wero1414/hack-it-back/Hw/sensor-co2/sensor-co2.step

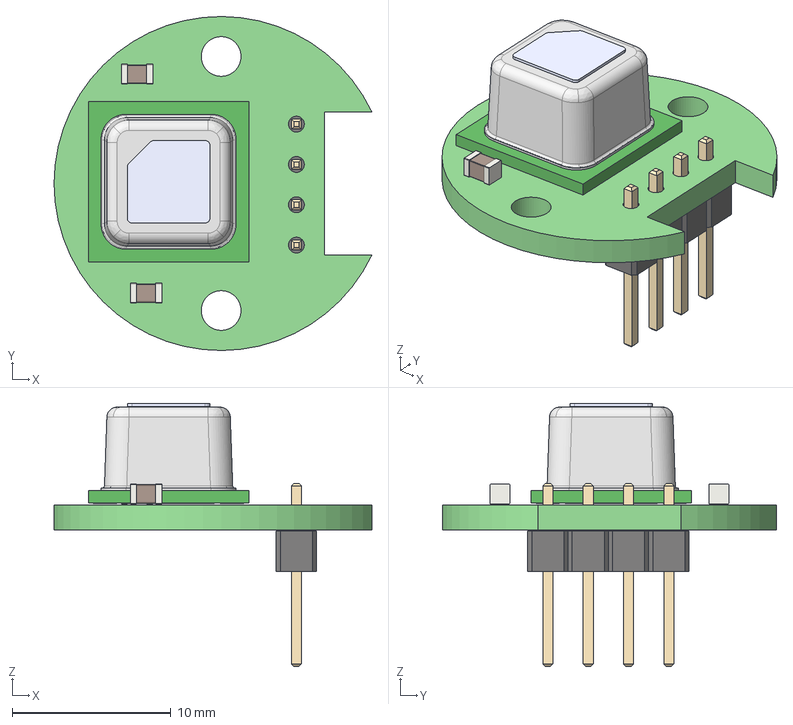
[picture p1: CAD file, 2022-03-23]
Hw/sensor-co2/sensor-co2.step
20.0 x 21.0 x 16.6 mm
sensor-co2 PCB
