wero1414/hack-it-back/Hw/sensor-exp/sensor-exp.step

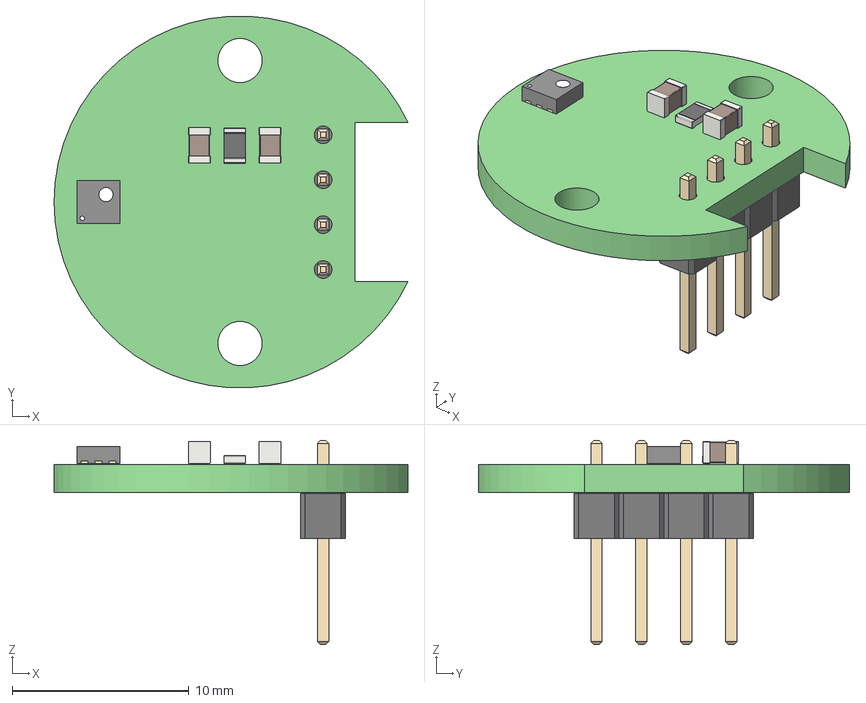
[picture p2: CAD file, 2022-03-23]
Hw/sensor-exp/sensor-exp.step
20.0 x 21.0 x 11.5 mm
_autosave-sensor-exp PCB
