wero1414/hack-it-back/Hw/main-board/Board2Pdf/main-board-Assembly.pdf

A

A

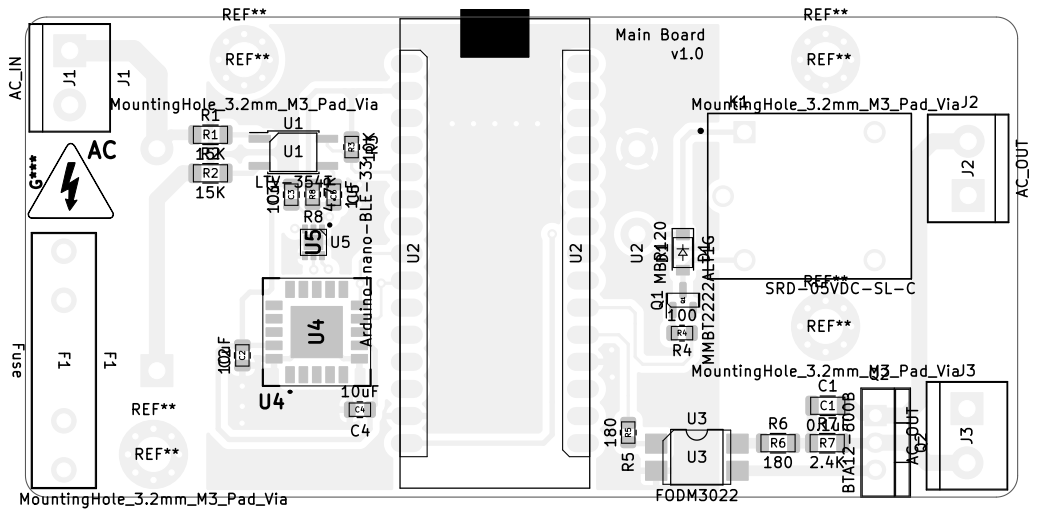
[picture p3: page 1]

PS1 1 | 2 | 3 | 4 | 5 | 6

A

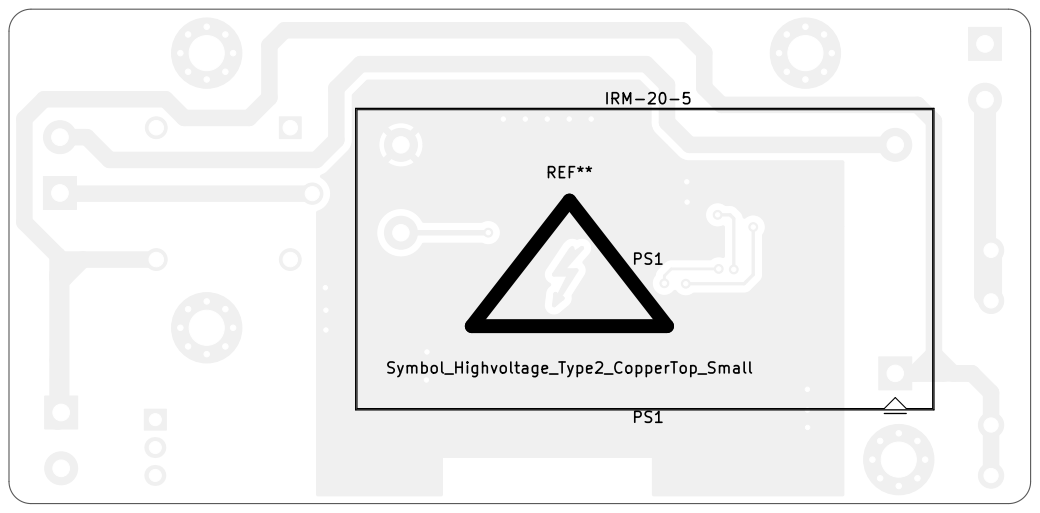
[picture p4: page 2]
D Date: KiCad E.D.A. kicad (6.0.0) Size: A4; Rev:; IRM-20-5 PS1 REF** Symbol_Highvoltage_Type2_CopperTop_Small

Sheet: Assembly
File: main-board.kicad_pcb
Id: 1/1 Title:
