wero1414/hack-it-back/Hw/main-board/main-board.kicad_pcb

## KiCad design Hw/main-board/main-board.kicad_pcb (2022-04-23)

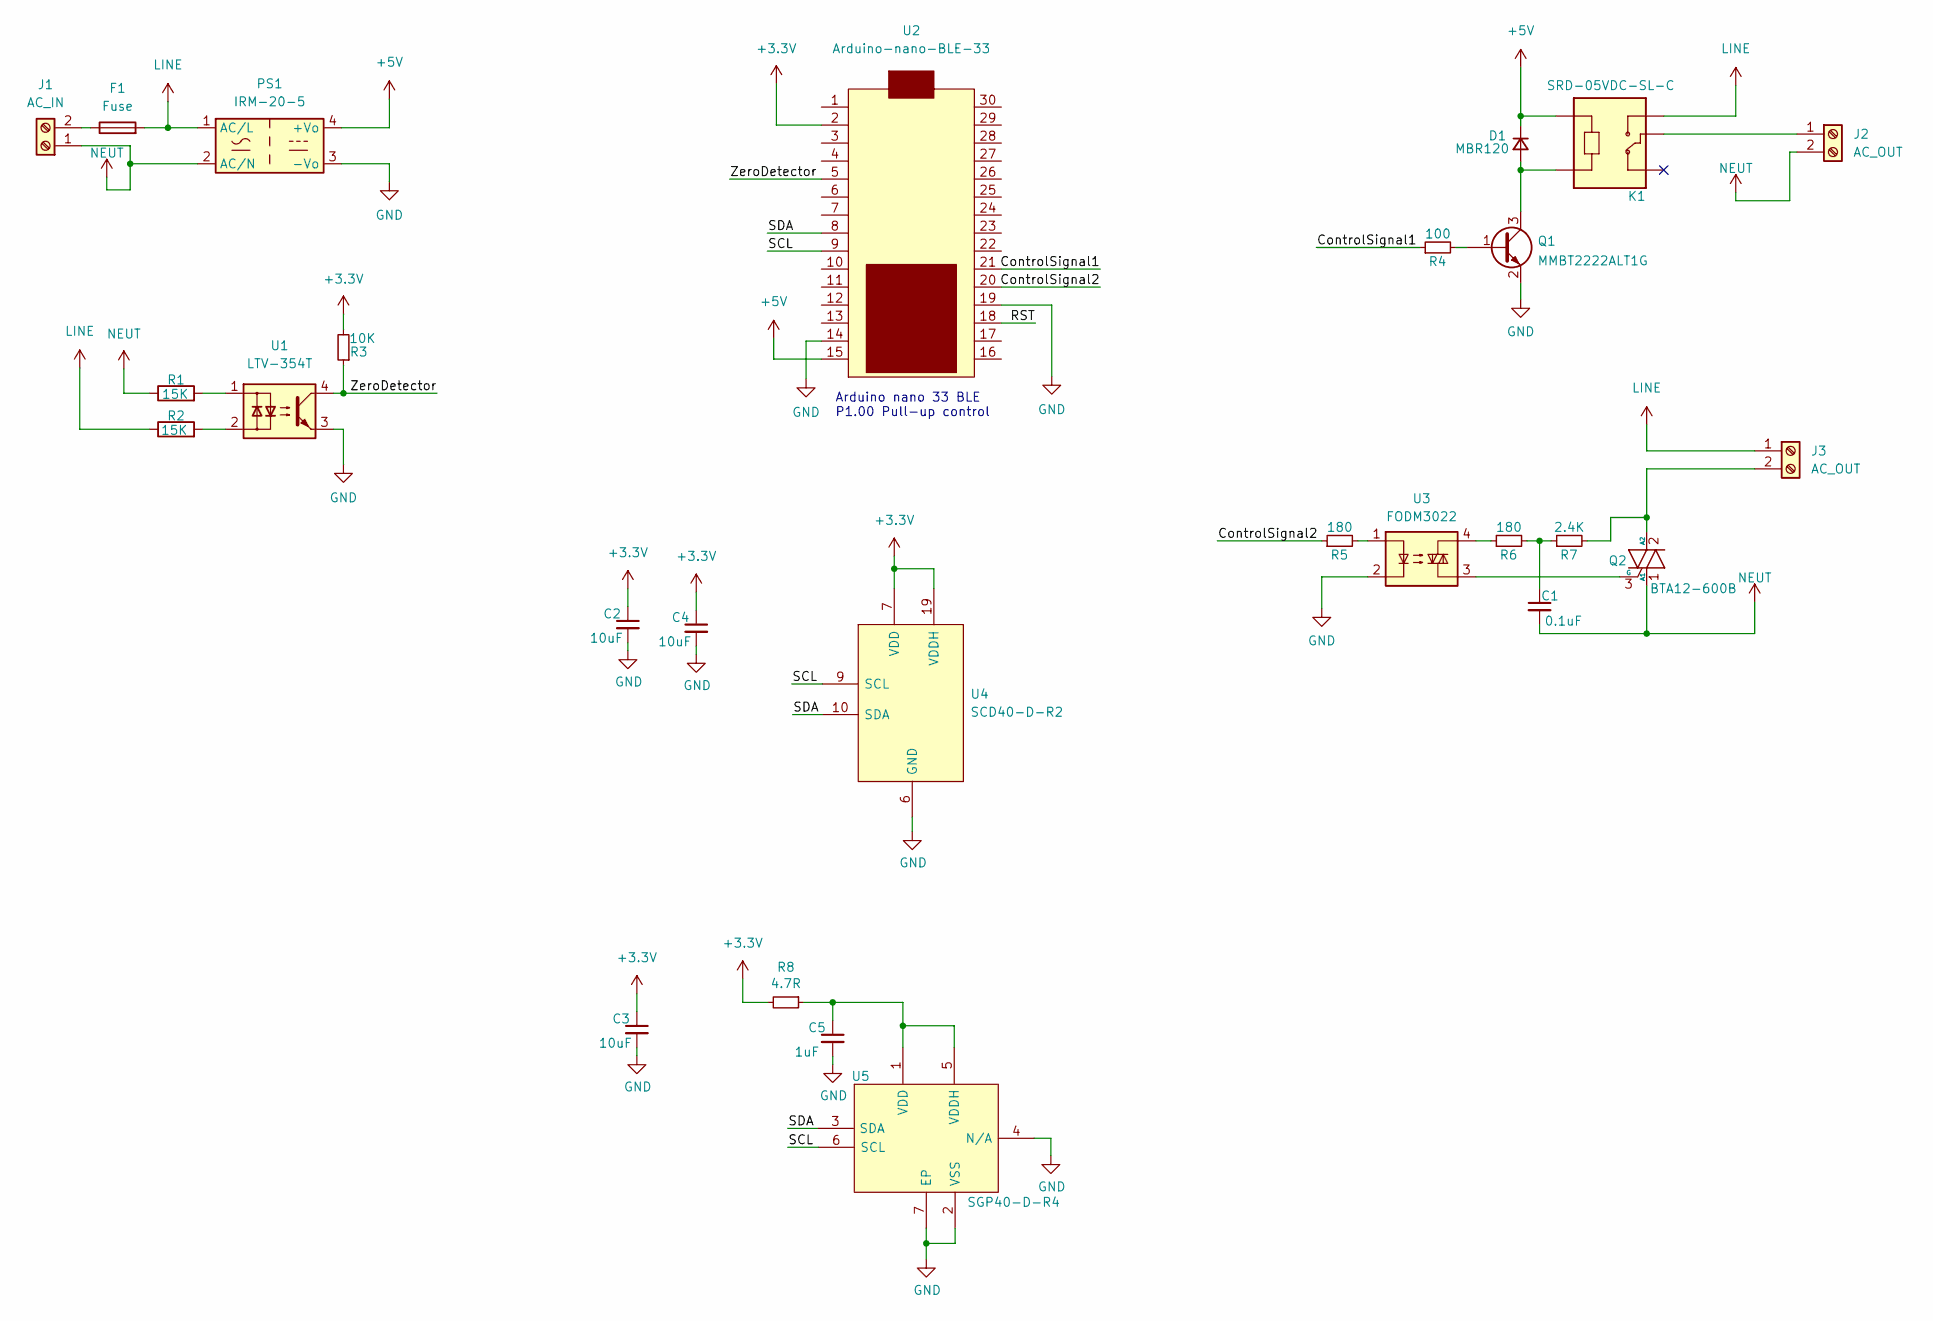
[picture p5: schematic main-board.kicad_sch]

Parts:
C1: 0.1uF; C_1206_3216Metric
C2, C3, C4: 10uF; C_0805_2012Metric
C5: 1uF; C_0805_2012Metric
D1: MBR120; D_SOD-123
F1: Fuse; Fuseholder_Littelfuse_100_series_5x20mm
J1: AC_IN; TerminalBlock_bornier-2_P5.08mm
J2, J3: AC_OUT; TerminalBlock_bornier-2_P5.08mm
K1: SRD-05VDC-SL-C; RELAY_SRD-05VDC-SL-C
PS1: IRM-20-5; Converter_ACDC_MeanWell_IRM-20-xx_THT
Q1: MMBT2222ALT1G; SOT-23
Q2: BTA12-600B; TO-220-3_Vertical
R1, R2: 15K; R_1206_3216Metric
R3: 10K; R_0805_2012Metric
R4: 100; R_0805_2012Metric
R5: 180; R_0805_2012Metric
R6: 180; R_1206_3216Metric
R7: 2.4K; R_1206_3216Metric
R8: 4.7R; R_0805_2012Metric
U1: LTV-354T; SO-4_4.4x3.6mm_P2.54mm
U2: Arduino-nano-BLE-33; NANO_33_Footprint_SMD_Castell
U3: FODM3022; SMDIP-4_W7.62mm
U4: SCD40-D-R2; SCD40DR2
U5: SGP40-D-R4; SON80P244X244X95-7N

Connections:
+3V3: C2.1, C3.1, C4.1, R3.2, R8.2, U2.2, U4.7 (VDD), U4.19 (VDDH)
+5V: D1.1 (K), K1.A1, PS1.4 (+Vo), U2.15
/ControlSignal1: R4.1, U2.21
/ControlSignal2: R5.1, U2.20
/RST: U2.18
/SCL: U2.9, U4.9 (SCL), U5.6 (SCL)
/SDA: U2.8, U4.10 (SDA), U5.3 (SDA)
/ZeroDetector: R3.1, U1.4, U2.5
GND: C2.2, C3.2, C4.2, C5.2, PS1.3 (-Vo), Q1.2 (E), U1.3, U2.14, U2.19, U3.2, U4.6 (GND), U4.20 (GND_2), U4.21 (GND_3), U5.2 (VSS), U5.4 (N/A), U5.7 (EP)
LINE: F1.2, J3.1, K1.NO, PS1.1 (AC/L), R2.1
NEUT: C1.2, J1.1, J2.2, PS1.2 (AC/N), Q2.1 (A1), R1.1
unnamed: C1.1, R6.2, R7.1
unnamed: C5.1, R8.1, U5.1 (VDD), U5.5 (VDDH)
unnamed: D1.2 (A), K1.A2, Q1.3 (C)
unnamed: F1.1, J1.2
unnamed: J2.1, K1.COM
unnamed: J3.2, Q2.2 (A2), R7.2
unnamed: Q1.1 (B), R4.2
unnamed: Q2.3 (G), U3.3
unnamed: R1.2, U1.1
unnamed: R2.2, U1.2
unnamed: R5.2, U3.1
unnamed: R6.1, U3.4

Notes on the sheet:
Arduino nano 33 BLE P1.00 Pull-up control

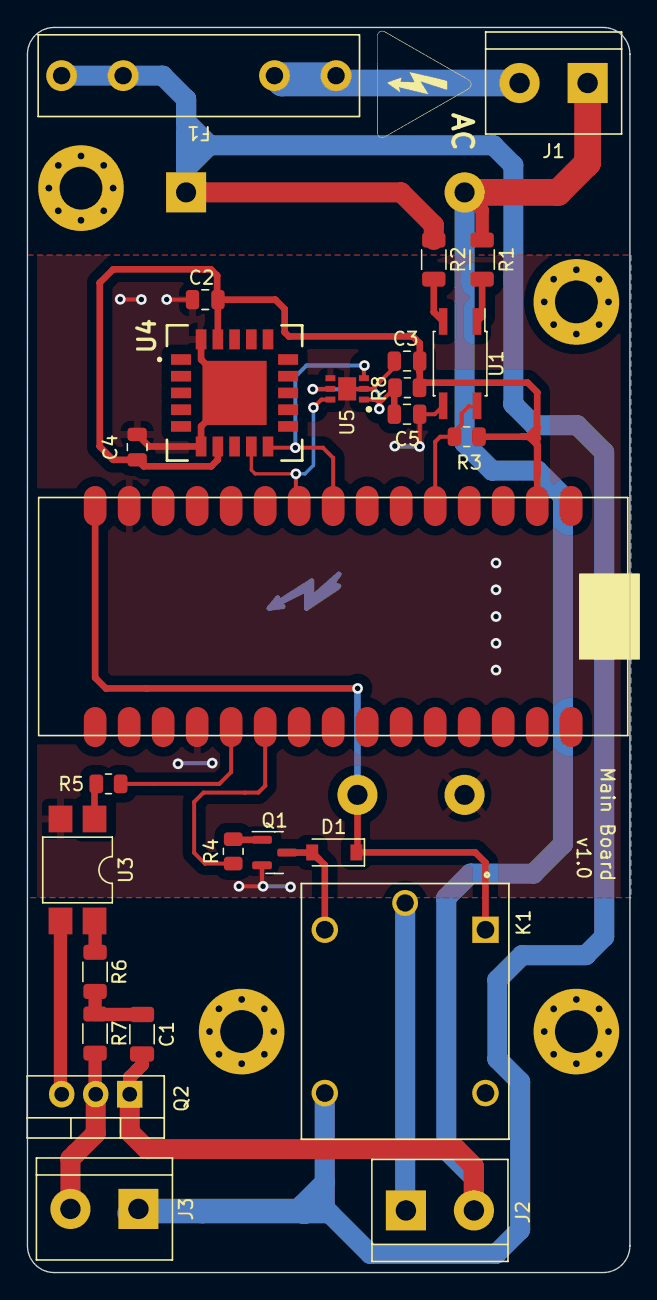
[picture p6: board main-board.kicad_pcb from above]

Board: 2 copper layers, 45.0 x 93.0 mm, 27 parts (1 on the bottom side), 22 nets.
