wero1414/hack-it-back/Hw/sensor-co2/sensor-co2.kicad_pcb

## KiCad design Hw/sensor-co2/sensor-co2.kicad_pcb (2022-03-23)

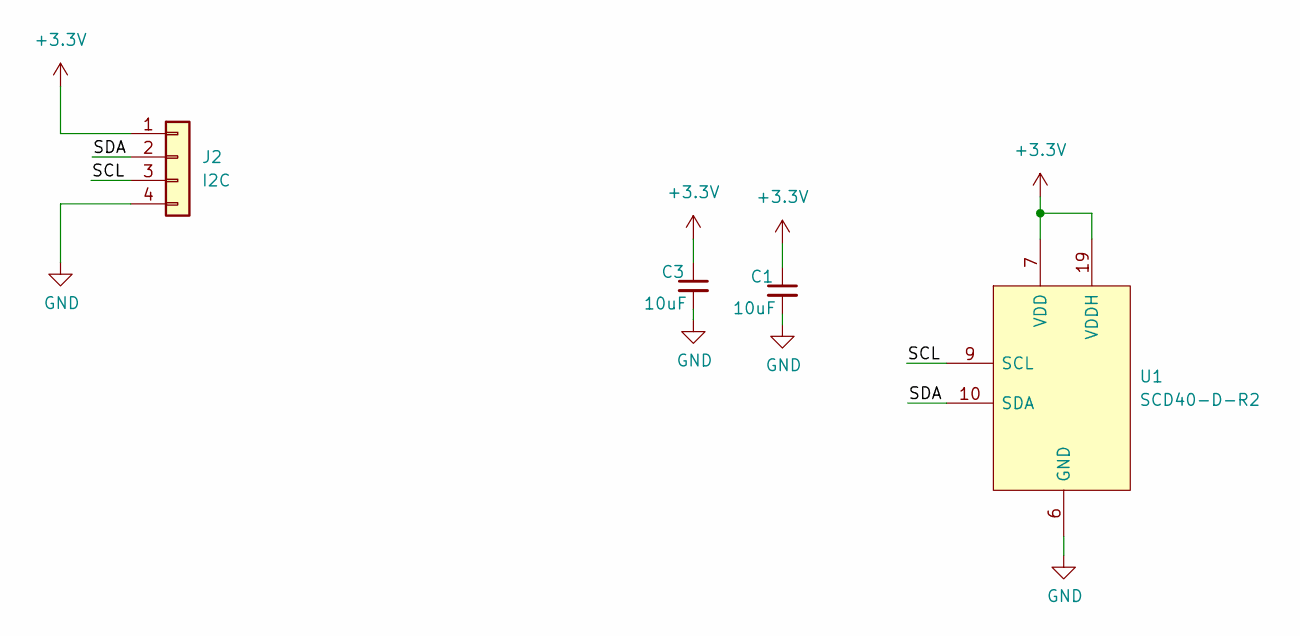
[picture p7: schematic sensor-co2.kicad_sch]

Parts:
C1, C3: 10uF; C_0805_2012Metric
J2: I2C; PinHeader_1x04_P2.54mm_Vertical
U1: SCD40-D-R2; SCD40DR2

Connections:
+3V3: C1.1, C3.1, J2.1, U1.7 (VDD), U1.19 (VDDH)
/SCL: J2.3, U1.9 (SCL)
/SDA: J2.2, U1.10 (SDA)
GND: C1.2, C3.2, J2.4, U1.6 (GND), U1.20 (GND_2), U1.21 (GND_3)

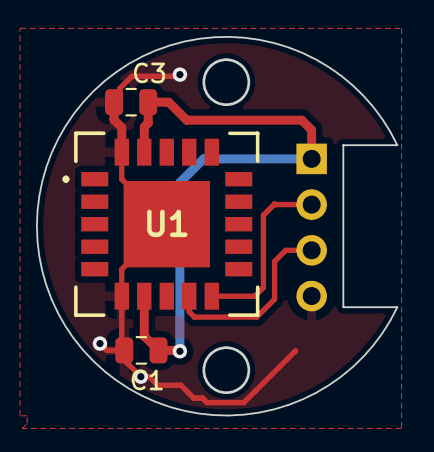
[picture p8: board sensor-co2.kicad_pcb from above]

Board: 2 copper layers, 20.0 x 21.0 mm, 4 parts (1 on the bottom side), 4 nets.
