wero1414/hack-it-back/Hw/sensor-exp/sensor-exp.kicad_pcb

## KiCad design Hw/sensor-exp/sensor-exp.kicad_pcb (2022-03-23)

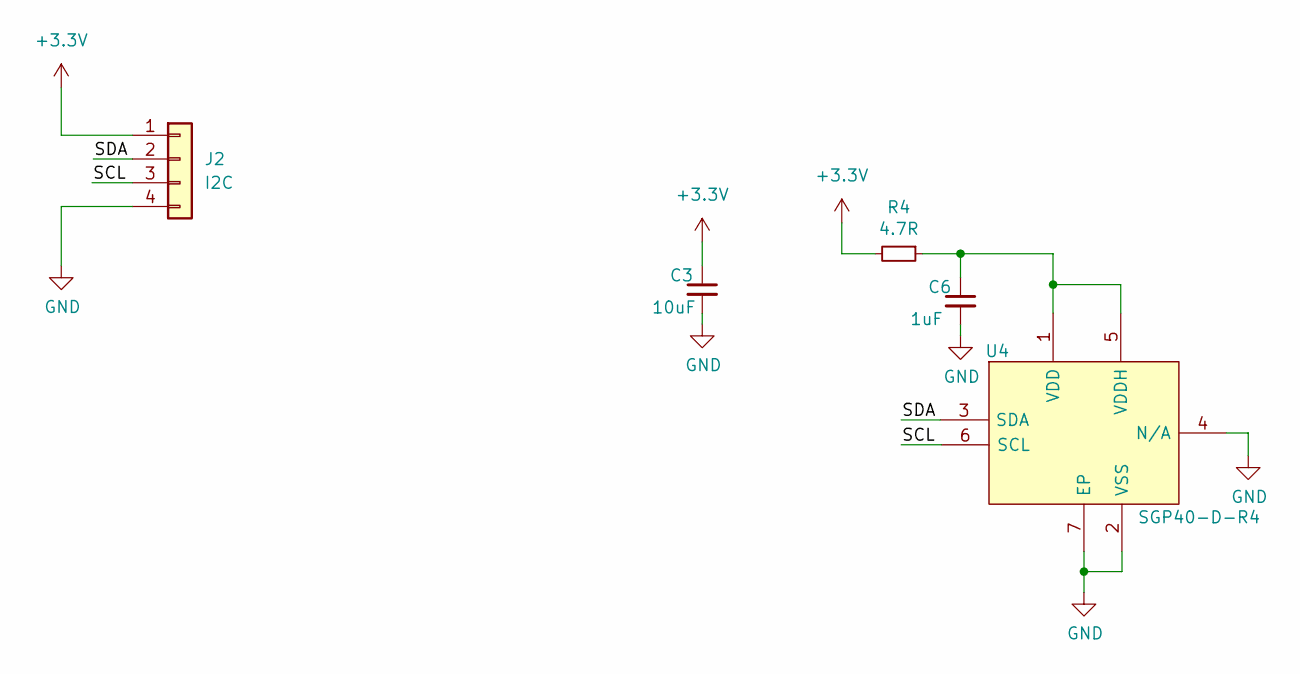
[picture p9: schematic sensor-exp.kicad_sch]

Parts:
C3: 10uF; C_0805_2012Metric
C6: 1uF; C_0805_2012Metric
J2: I2C; PinHeader_1x04_P2.54mm_Vertical
R4: 4.7R; R_0805_2012Metric
U4: SGP40-D-R4; SON80P244X244X95-7N

Connections:
+3V3: C3.1, J2.1, R4.2
/SCL: J2.3, U4.6 (SCL)
/SDA: J2.2, U4.3 (SDA)
GND: C3.2, C6.2, J2.4, U4.2 (VSS), U4.4 (N/A), U4.7 (EP)
unnamed: C6.1, R4.1, U4.1 (VDD), U4.5 (VDDH)

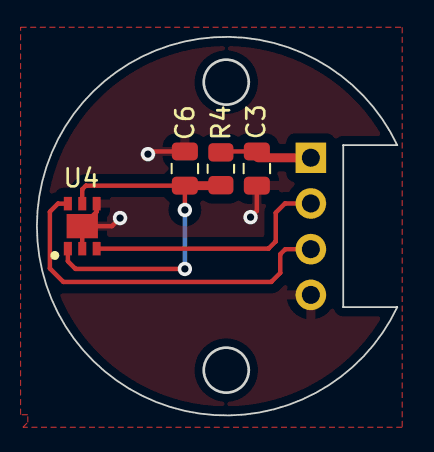
[picture p10: board sensor-exp.kicad_pcb from above]

Board: 2 copper layers, 20.0 x 21.0 mm, 5 parts (1 on the bottom side), 5 nets.
