wero1414/hack-it-back/Hw/sensor-board/sensor-board.kicad_pcb

## KiCad design Hw/sensor-board/sensor-board.kicad_pcb (2022-03-23)

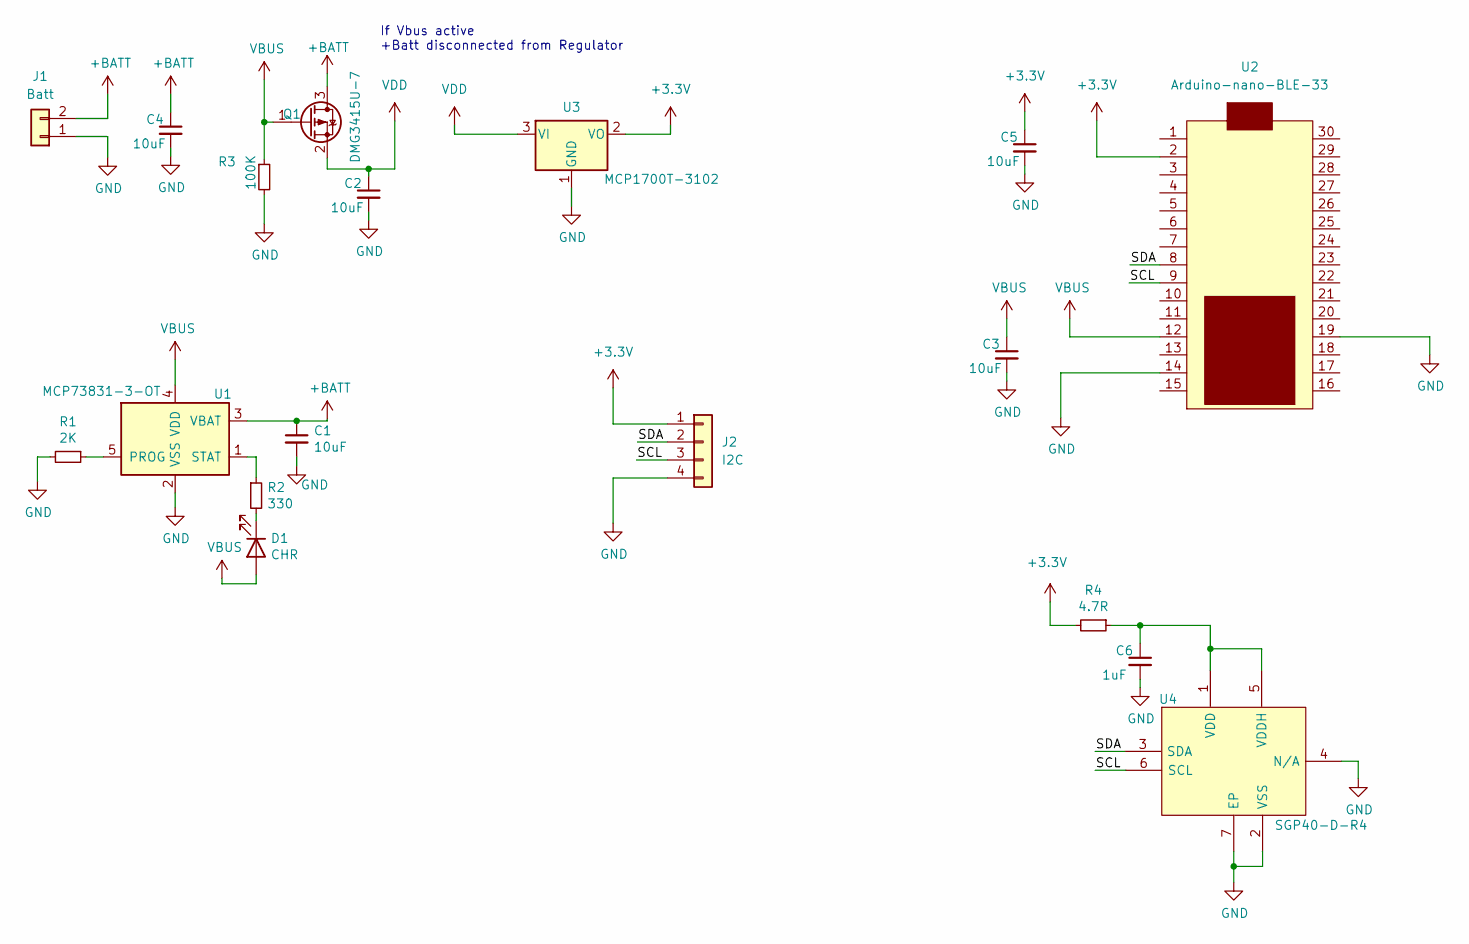
[picture p11: schematic sensor-board.kicad_sch]

Parts:
C1, C2, C3, C4, C5: 10uF; C_0805_2012Metric
C6: 1uF; C_0805_2012Metric
D1: CHR; LED_0805_2012Metric_Pad1.15x1.40mm_HandSolder
J1: Batt; PinHeader_1x02_P2.54mm_Vertical
J2: I2C; PinHeader_1x04_P2.54mm_Vertical
Q1: DMG3415U-7; SOT-23
R1: 2K; R_0805_2012Metric
R2: 330; R_0805_2012Metric
R3: 100K; R_0805_2012Metric
R4: 4.7R; R_0805_2012Metric
U1: MCP73831-3-OT; SOT-23-5
U2: Arduino-nano-BLE-33; NANO_33_Footprint_SMD_Castell
U3: MCP1700T-3102; SOT-23
U4: SGP40-D-R4; SON80P244X244X95-7N

Connections:
+3V3: C5.1, J2.1, R4.2, U2.2, U3.2 (VO)
+BATT: C1.1, C4.1, J1.2, Q1.3 (D), U1.3 (VBAT)
/SCL: J2.3, U2.9, U4.6 (SCL)
/SDA: J2.2, U2.8, U4.3 (SDA)
GND: C1.2, C2.2, C3.2, C4.2, C5.2, C6.2, J1.1, J2.4, R1.2, R3.2, U1.2 (VSS), U2.14, U2.19, U3.1 (GND), U4.2 (VSS), U4.4 (N/A), U4.7 (EP)
unnamed: C6.1, R4.1, U4.1 (VDD), U4.5 (VDDH)
unnamed: D1.1 (K), R2.2
unnamed: R1.1, U1.5 (PROG)
unnamed: R2.1, U1.1 (STAT)
VBUS: C3.1, D1.2 (A), Q1.1 (G), R3.1, U1.4 (VDD), U2.12
VDD: C2.1, Q1.2 (S), U3.3 (VI)

Notes on the sheet:
If Vbus active +Batt disconnected from Regulator

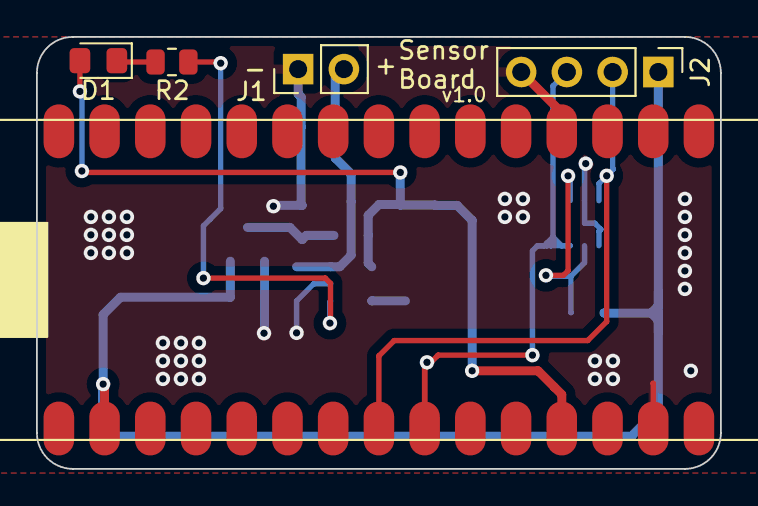
[picture p12: board sensor-board.kicad_pcb from above]

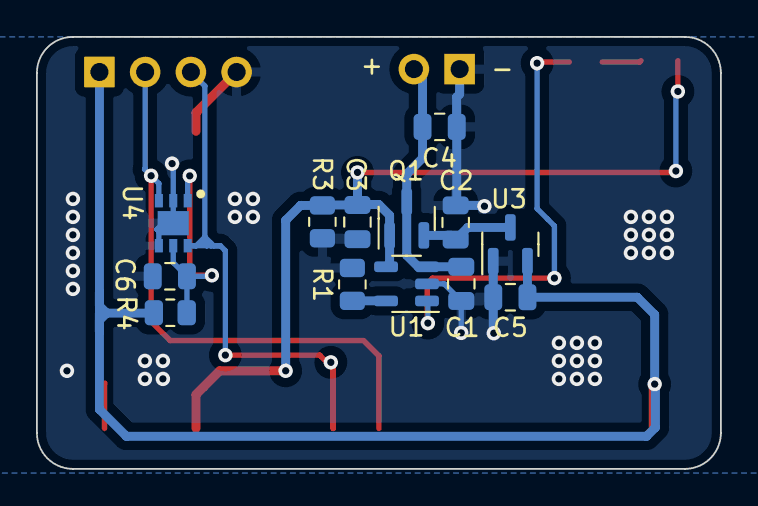
[picture p13: board sensor-board.kicad_pcb from below]

Board: 2 copper layers, 38.0 x 24.0 mm, 18 parts (13 on the bottom side), 11 nets.
