wero1414/hack-it-back/(commit log)

2022-03-07 add kicad projects
    [main-board.kicad_pcb, main-board.kicad_sch, sensor-board.kicad_pcb, sensor-board.kicad_sch]
2022-03-07 update sensor board schematic
    [sensor-board.kicad_pcb, sensor-board.kicad_sch]
2022-03-14 update sensors and sensorBoard
    [sensor-board.kicad_pcb, sensor-board.kicad_sch, sensor-co2.kicad_pcb, sensor-co2.kicad_sch, sensor-co2.step, sensor-exp.kicad_pcb, sensor-exp.kicad_sch, sensor-exp.step]
2022-03-14 update pins sensor board
    [sensor-board.kicad_pcb, sensor-board.kicad_sch]
2022-03-14 update main board
    [main-board.kicad_pcb, main-board.kicad_sch]
2022-03-14 add step files
    [main-board.kicad_pcb]
2022-03-14 update sensor board v1.0
    [sensor-board.kicad_pcb, sensor-board.kicad_sch]
2022-03-14 update board v1.0
    [main-board.kicad_pcb]
2022-03-23 add gerbers
    [main-board-B_Cu.gbr, main-board-B_Mask.gbr, main-board-B_Paste.gbr, main-board-B_Silkscreen.gbr, main-board-Edge_Cuts.gbr, main-board-F_Cu.gbr, main-board-F_Mask.gbr, main-board-F_Paste.gbr]
2022-03-23 move to hardware folder
    [main-board-B_Cu.gbr, main-board-B_Mask.gbr, main-board-B_Paste.gbr, main-board-B_Silkscreen.gbr, main-board-Edge_Cuts.gbr, main-board-F_Cu.gbr, main-board-F_Mask.gbr, main-board-F_Paste.gbr]
2022-04-23 update Kicad project
    [main-board.kicad_pcb]
2022-04-28 add readings of BLE found bug
    [CentralHackItBack.ino]
